ohammer-ai/Nova-papertape-emulator/papertape_frontpanel.png

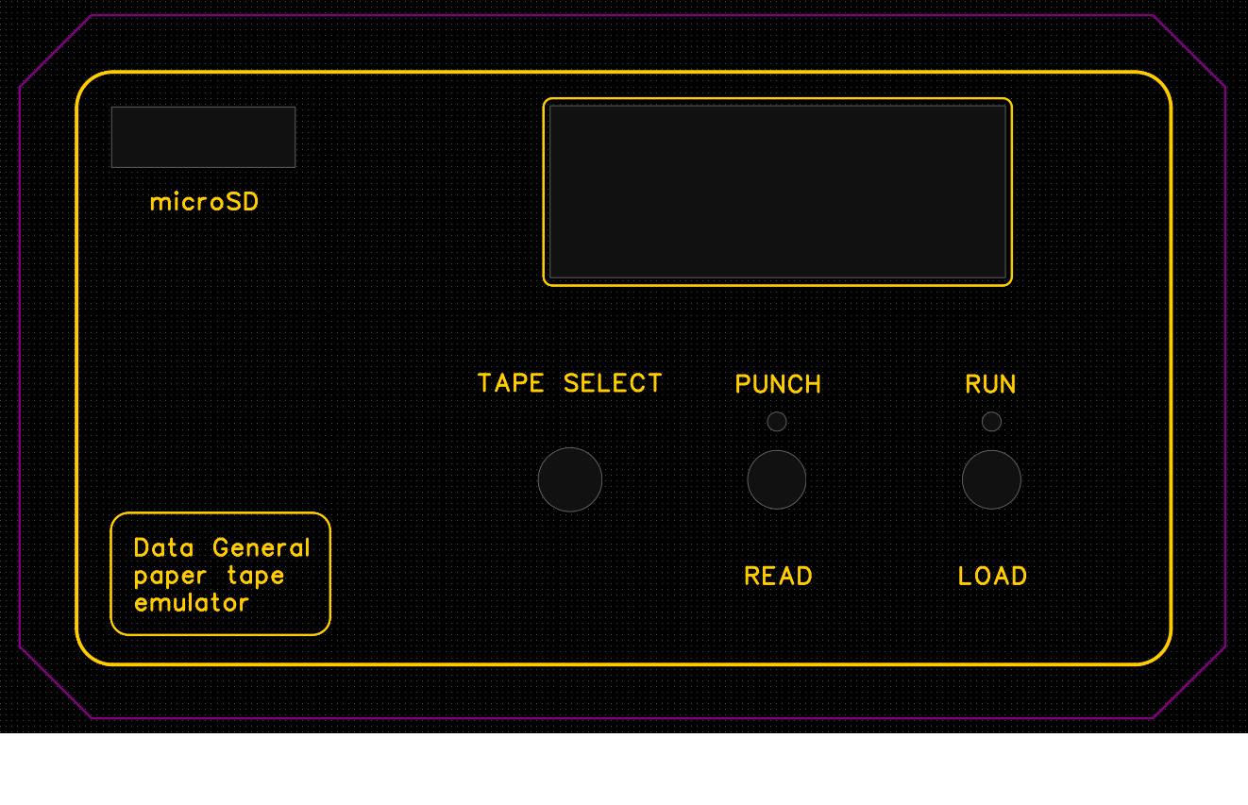
papertape_frontpanel.png
