ohammer-ai/Nova-papertape-emulator/PTR SD bracket rev1.stl

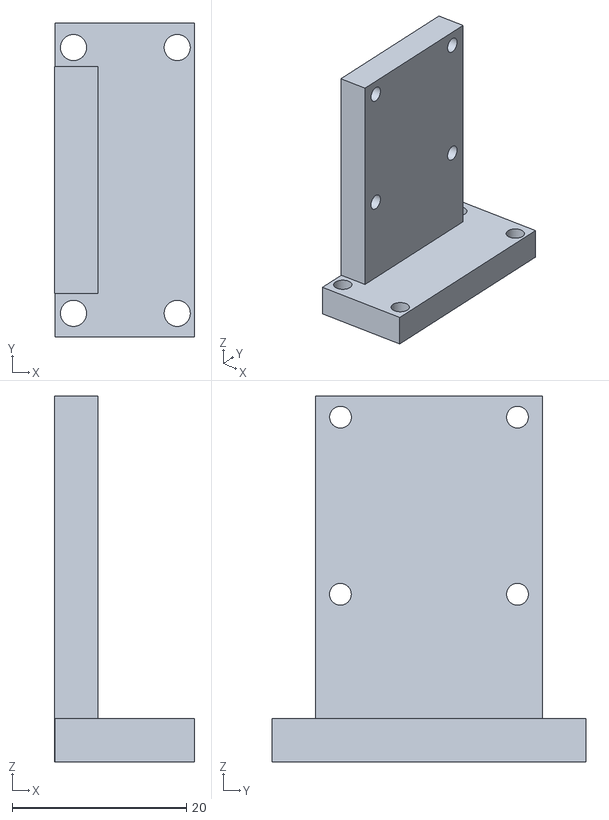
[picture p4: CAD file, 2026-10-11]
PTR SD bracket rev1.stl
16.1 x 36.0 x 42.0
